MuYukio/horta-automatica-arduino/README.md

#  Horta Automática com Arduino

Projeto de **sistema de irrigação automatizado utilizando Arduino**, desenvolvido com foco em **sustentabilidade**, **automação** e **aplicação educacional**, especialmente voltado para o contexto de **hortas escolares**.

O projeto automatiza o processo de irrigação a partir da leitura da umidade do solo, contribuindo para o uso consciente da água e para o ensino prático de tecnologia, eletrônica e programação.

---

##  Visão Geral

A Horta Automática utiliza sensores de umidade do solo para monitorar as condições das plantas e acionar automaticamente o sistema de irrigação quando necessário.  
O controle é realizado por um microcontrolador Arduino, responsável pela tomada de decisão, registro de eventos e acionamento dos atuadores.

Além do aspecto técnico, o projeto possui forte **caráter educacional e sustentável**, sendo aplicado em ambiente escolar e utilizado como ferramenta de aprendizagem interdisciplinar.

---

##  Funcionalidades

- Mede automaticamente a umidade do solo
- Decide quando irrigar com base nos dados coletados
- Liga e desliga a irrigação sem intervenção humana
- Registra o histórico de funcionamento do sistema
- Exibe informações do sistema em tempo real
- Funciona de forma autônoma e segura
- Pode ser aplicado em hortas e viveiros escolares

##  Componentes Utilizados

- Arduino (Uno, Mega ou compatível)
- Sensores de umidade do solo
- Módulo relé
- Válvulas solenoide e/ou bomba de água
- Display LCD (opcional)
- Fonte de alimentação / bateria
- Jumpers, protoboard e demais componentes eletrônicos

---

##  Manual Técnico do Projeto (PDF)

O manual técnico completo do projeto está disponível em formato PDF e contém:

- Descrição detalhada do funcionamento do sistema  
- Explicação do código Arduino  
- Orientações de montagem do circuito  
- Considerações sobre sustentabilidade e aplicação educacional  

 **Clique no link abaixo para acessar ou baixar o manual:**

 [Download do Manual da Horta Automática (PDF)](Manual/manual_horta_automatica.pdf)

---

##  Como utilizar o projeto

1. Abra o arquivo `.ino` na **Arduino IDE**
2. Conecte a placa Arduino ao computador
3. Selecione a placa e a porta corretas
4. Faça o upload do código
5. Monte o circuito conforme descrito no manual técnico
6. Alimente o sistema e acompanhe o funcionamento da irrigação automática

---

##  Premiações e Reconhecimentos

Este projeto foi reconhecido em âmbito nacional no **Programa Vitrine Tetra Pak**, iniciativa realizada pela **Tetra Pak** em parceria com a ONG **Argilando**, que desde 2021 premia projetos socioambientais desenvolvidos por jovens brasileiros com foco em sustentabilidade, inovação e impacto social.

Na edição de **2025**, o projeto foi contemplado com as seguintes premiações:

-  **Projeto Mais Sustentável da Região Centro-Oeste** — Programa Vitrine Tetra Pak (2025)  
-  **Projeto Inovador** — Programa Vitrine Tetra Pak (2025)

O programa oferece mentoria voluntária por profissionais da Tetra Pak e tem como objetivo incentivar soluções que contribuam para a proteção do alimento, das pessoas e do planeta, valorizando iniciativas de impacto socioambiental positivo desenvolvidas por jovens.

---
##  Contexto Acadêmico

Projeto desenvolvido no contexto acadêmico, com foco em:
- Sustentabilidade
- Automação
- Tecnologia aplicada à educação
- Uso consciente de recursos naturais

---

##  Autor

**Murilo Yukio**  
**Domini Acco**  
Projeto desenvolvido para fins educacionais e acadêmicos.

---

## Licença

Este projeto é destinado a fins educacionais.  
Sinta-se à vontade para estudar, adaptar e reutilizar, desde que os créditos sejam mantidos.
